ddkn/pwjsignal/pcb/pwjsignal/pwjsignal_rev_b.png

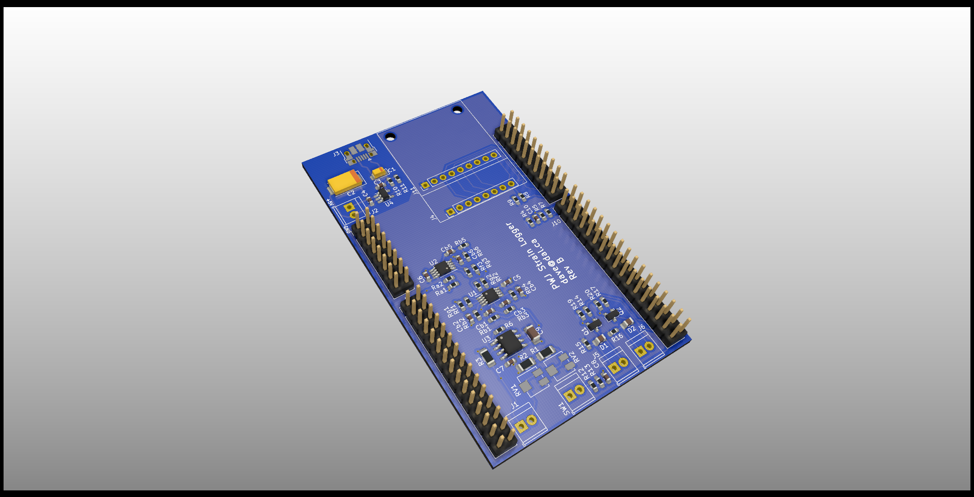
pcb/pwjsignal/pwjsignal_rev_b.png
