ddkn/pwjsignal/pcb/pwjsignal/pwjsignal.png

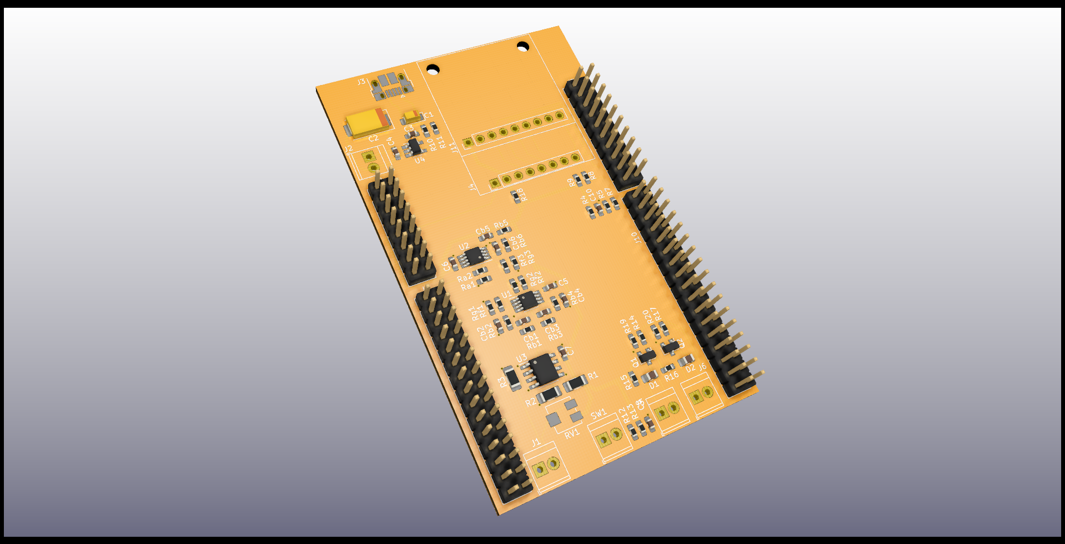
pcb/pwjsignal/pwjsignal.png
