ddkn/pwjsignal/README.md

# PWJSignal Daughter Board

This is the daughter board to the [pwjrtos](https://github.com/nanomagneticslab/pwjrtos)
OS. This was built using KiCAD v5.1.5.

These are design files for the PCB; this includes,

* Schematics
* PCB layouts
* Gerbers (for PCB manufacturers)
* Datasheet references
