ddkn/pwjsignal/pcb/pwjsignal/pwjsignal.kicad_pcb

## KiCad design pcb/pwjsignal/pwjsignal.kicad_pcb (2021-06-24)

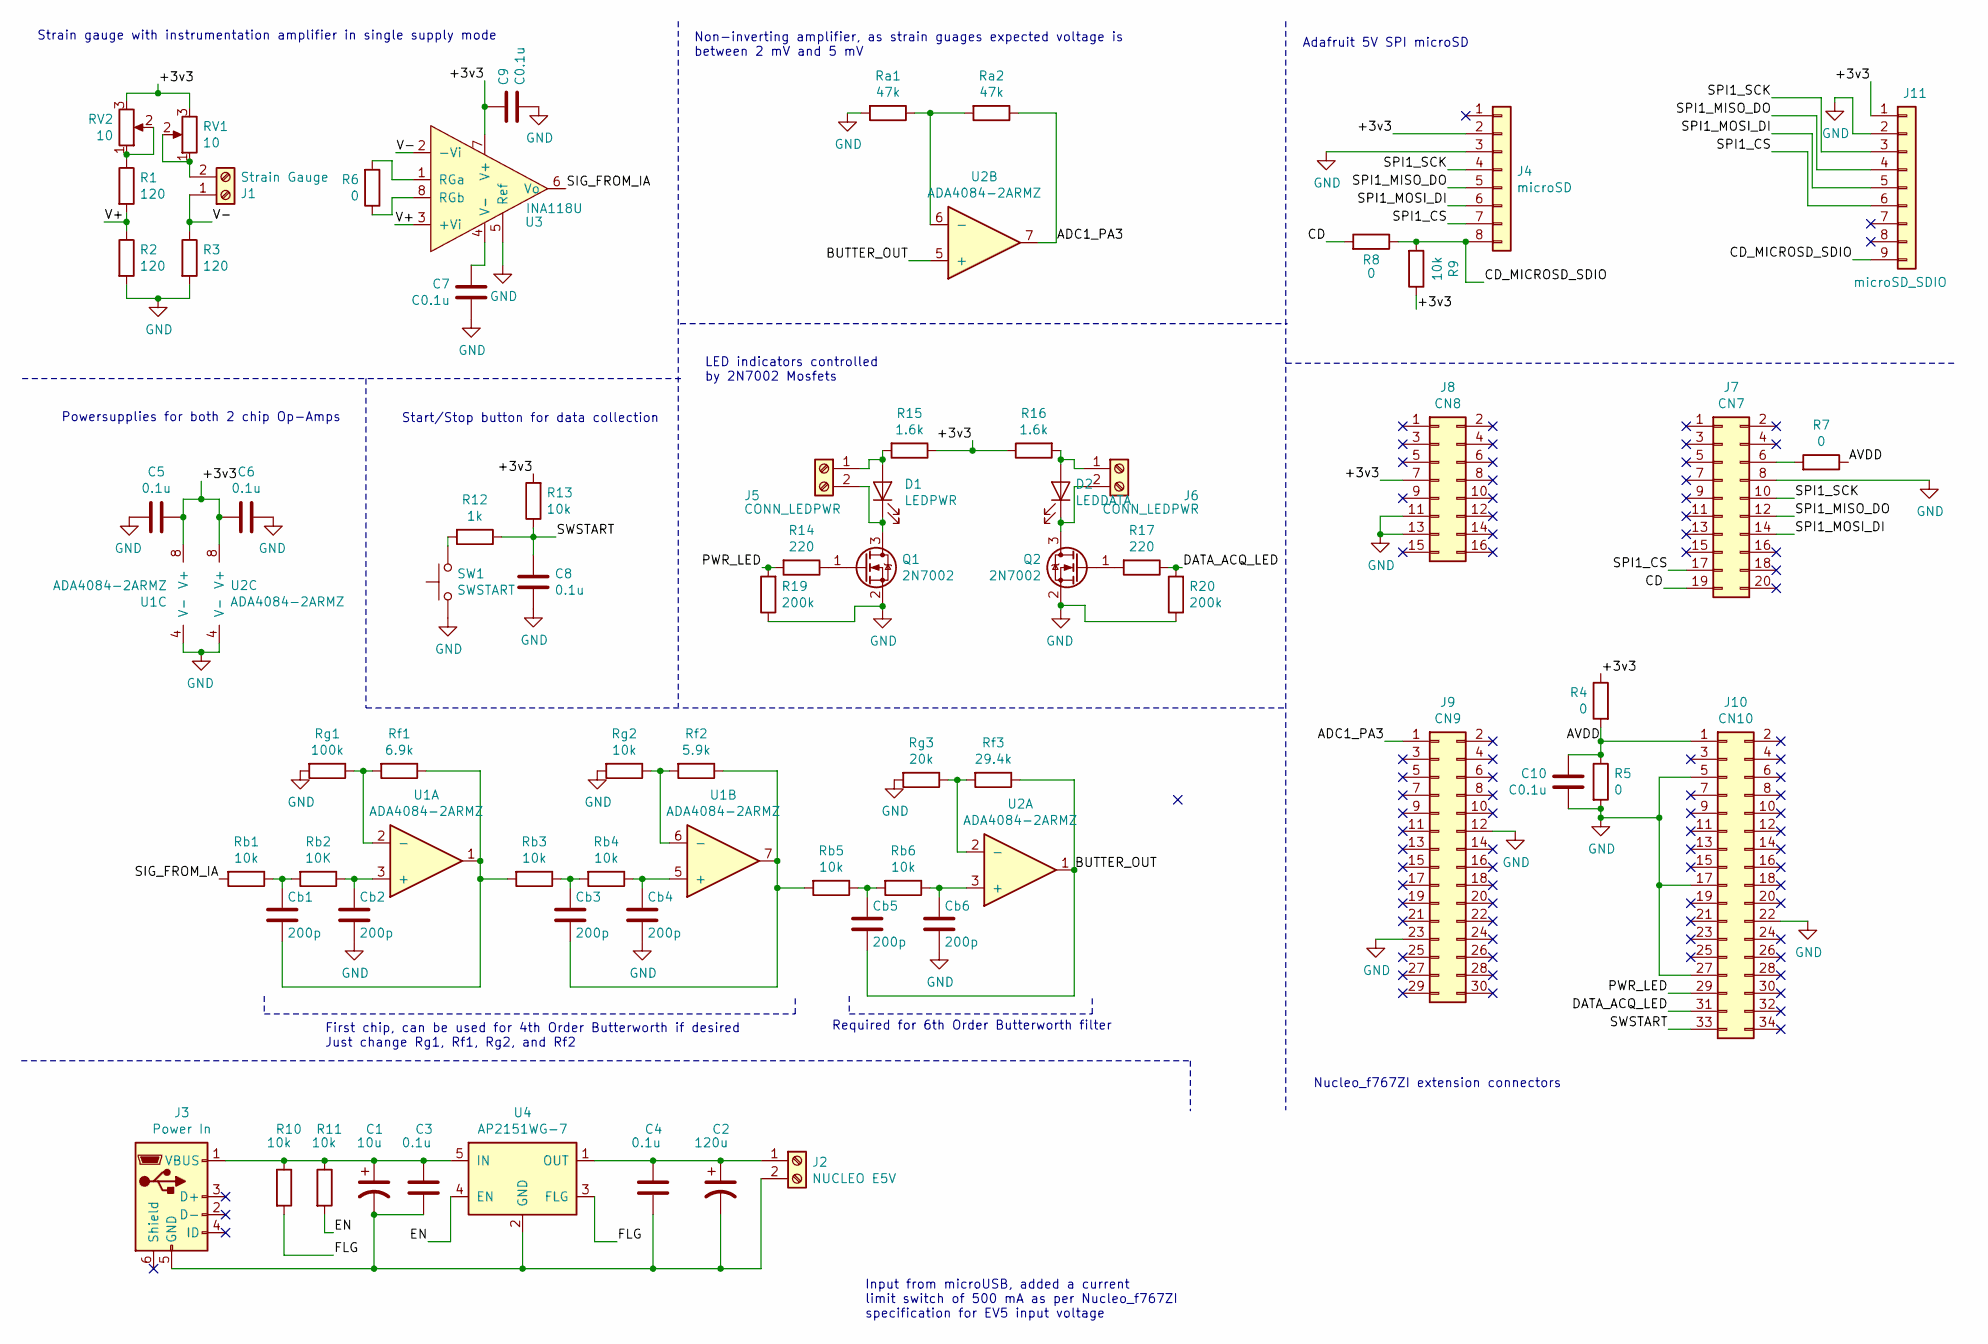
[picture p3: schematic pwjsignal.sch, PWJ Strain Logger]

Parts:
C1: 10u; CP_EIA-3216-18_Kemet-A_Pad1.58x1.35mm_HandSolder; MPN TAJA106K006SNJ
C2: 120u; CP_EIA-7343-15_Kemet-W_Pad2.25x2.55mm_HandSolder; MPN 293D127X96R3D2TE3
C3, C4, C5, C6, C8: 0.1u; C_0603_1608Metric_Pad1.05x0.95mm_HandSolder
C7, C10: C0.1u; C_0603_1608Metric_Pad1.05x0.95mm_HandSolder
C9: C0.1u; C_1206_3216Metric_Pad1.42x1.75mm_HandSolder
Cb1, Cb2, Cb3, Cb4, Cb5, Cb6: 200p; C_0603_1608Metric_Pad1.05x0.95mm_HandSolder
D1: LEDPWR; C_0805_2012Metric_Pad1.15x1.40mm_HandSolder; MPN APT2012LVBC/D
D2: LEDDATA; C_0805_2012Metric_Pad1.15x1.40mm_HandSolder; MPN APT2012LSECK/J4-PRV
J1: Strain Gauge; TerminalBlock_TE_282834-2_1x02_P2.54mm_Horizontal; MPN 1546215-2
J2: NUCLEO E5V; TerminalBlock_TE_282834-2_1x02_P2.54mm_Horizontal; MPN 1546215-2
J3: Power In; USB_Micro-B_Amphenol_10103594-0001LF_Horizontal; MPN 10103594-0001LF
J4: microSD; Adafruit_microSD_breakout_Alt; MPN 61300811121
J5, J6: CONN_LEDPWR; TerminalBlock_TE_282834-2_1x02_P2.54mm_Horizontal; MPN 1546215-2
J7: CN7; PinHeader_2x10_P2.54mm_Vertical; MPN 61307221121
J8: CN8; PinHeader_2x08_P2.54mm_Vertical; MPN 61307221121
J9: CN9; PinHeader_2x15_P2.54mm_Vertical; MPN 61307221121
J10: CN10; PinHeader_2x17_P2.54mm_Vertical; MPN 61307221121
J11: microSD_SDIO; Adafruit_microSD_SDIO_breakout
Q1, Q2: 2N7002; SOT-23; MPN 2N7002A-7
R1, R2, R3: 120; R_1206_3216Metric_Pad1.42x1.75mm_HandSolder
R4, R5, R6, R7, R8: 0; R_0603_1608Metric_Pad1.05x0.95mm_HandSolder
R9, R10, R11, R13: 10k; R_0603_1608Metric_Pad1.05x0.95mm_HandSolder
R12: 1k; R_0603_1608Metric_Pad1.05x0.95mm_HandSolder
R14, R17: 220; R_0603_1608Metric_Pad1.05x0.95mm_HandSolder
R15, R16: 1.6k; R_0603_1608Metric_Pad1.05x0.95mm_HandSolder
R19, R20: 200k; R_0603_1608Metric_Pad1.05x0.95mm_HandSolder
RV1, RV2: 10; Potentiometer_Bourns_3214J_Horizontal; MPN PVG3A200C01R00
Ra1, Ra2: 47k; R_0603_1608Metric_Pad1.05x0.95mm_HandSolder
Rb1, Rb3, Rb4, Rb5, Rb6: 10k; R_0603_1608Metric_Pad1.05x0.95mm_HandSolder
Rb2: 10K; R_0603_1608Metric_Pad1.05x0.95mm_HandSolder
Rf1: 6.9k; R_0603_1608Metric_Pad1.05x0.95mm_HandSolder
Rf2: 5.9k; R_0603_1608Metric_Pad1.05x0.95mm_HandSolder
Rf3: 29.4k; R_0603_1608Metric_Pad1.05x0.95mm_HandSolder
Rg1: 100k; R_0603_1608Metric_Pad1.05x0.95mm_HandSolder
Rg2: 10k; R_0603_1608Metric_Pad1.05x0.95mm_HandSolder
Rg3: 20k; R_0603_1608Metric_Pad1.05x0.95mm_HandSolder
SW1: SWSTART; TerminalBlock_TE_282834-2_1x02_P2.54mm_Horizontal
U1, U2: ADA4084-2ARMZ; MSOP-8_3x3mm_P0.65mm; MPN ADA4084-2ARMZ
U3: INA118U; SOIC-8_3.9x4.9mm_P1.27mm
U4: AP2151WG-7; SOT-23-5_HandSoldering; MPN AP2151WG-7

Connections:
/+3v3: C5.1, C6.2, C9.2, J4.2, J8.7, J11.1, R4.1, R9.1, R13.2, R15.1, R16.1, RV1.3, RV2.3, U1.8 (V+), U2.8 (V+), U3.7 (V+)
/ADC1_PA3: J9.1, Ra2.1, U2.7
/AVDD: C10.2, J10.1, R4.2, R5.1, R7.1
/BUTTER_OUT: Cb5.2, Rf3.1, U2.1, U2.5 (+)
/CD: J7.19, R8.2
/CD_MICROSD_SDIO: J4.8, J11.9, R8.1, R9.2
/DATA_ACQ_LED: J10.31, R17.1, R20.2
/EN: R11.2, U4.4 (EN)
/FLG: R10.2, U4.3 (FLG)
/PWR_LED: J10.29, R14.2, R19.2
/SIG_FROM_IA: Rb1.2, U3.6 (Vo)
/SPI1_CS: J4.7, J7.17, J11.6
/SPI1_MISO_DO: J4.5, J7.12, J11.4
/SPI1_MOSI_DI: J4.6, J7.14, J11.5
/SPI1_SCK: J4.4, J7.10, J11.3
/SWSTART: C8.1, J10.33, R12.1, R13.1
/V+: R1.2, R2.1, U3.3 (+Vi)
/V-: J1.1, R3.1, U3.2 (-Vi)
GND: C5.2, C6.1, C7.1, C8.2, C9.1, C10.1, Cb2.2, Cb4.2, Cb6.2, J4.3, J7.8, J8.11, J8.13, J9.12, J9.23, J10.5, J10.17, J10.22, J10.27, J11.2, Q1.2 (S), Q2.2 (S), R2.2, R3.2, R5.2, R19.1, R20.1, Ra1.2, Rg1.2, Rg2.2, Rg3.2, SW1.1, U1.4 (V-), U2.4 (V-), U3.5 (Ref)
unnamed: C1.1, C3.1, J3.1 (VBUS), R10.1, R11.1, U4.5 (IN)
unnamed: C1.2, C2.2, C3.2, C4.2, J2.2, J3.5 (GND), U4.2 (GND)
unnamed: C2.1, C4.1, J2.1, U4.1 (OUT)
unnamed: C7.2, U3.4 (V-)
unnamed: Cb1.1, Rb1.1, Rb2.2
unnamed: Cb1.2, Rb3.2, Rf1.1, U1.1
unnamed: Cb2.1, Rb2.1, U1.3 (+)
unnamed: Cb3.1, Rb3.1, Rb4.2
unnamed: Cb3.2, Rb5.2, Rf2.1, U1.7
unnamed: Cb4.1, Rb4.1, U1.5 (+)
unnamed: Cb5.1, Rb5.1, Rb6.2
unnamed: Cb6.1, Rb6.1, U2.3 (+)
unnamed: D1.1 (K), J5.2, Q1.3 (D)
unnamed: D1.2 (A), J5.1, R15.2
unnamed: D2.1 (K), J6.2, Q2.3 (D)
unnamed: D2.2 (A), J6.1, R16.2
unnamed: J1.2, RV1.1, RV1.2
unnamed: J7.6, R7.2
unnamed: Q1.1 (G), R14.1
unnamed: Q2.1 (G), R17.2
unnamed: R1.1, RV2.1, RV2.2
unnamed: R6.1, U3.8 (RGb)
unnamed: R6.2, U3.1 (RGa)
unnamed: R12.2, SW1.2
unnamed: Ra1.1, Ra2.2, U2.6 (-)
unnamed: Rf1.2, Rg1.1, U1.2 (-)
unnamed: Rf2.2, Rg2.1, U1.6 (-)
unnamed: Rf3.2, Rg3.1, U2.2 (-)

Notes on the sheet:
Input from microUSB, added a current limit switch of 500 mA as per Nucleo_f767ZI specification for EV5 input voltage
Adafruit 5V SPI microSD
Nucleo_f767ZI extension connectors
Strain gauge with instrumentation amplifier in single supply mode
Non-inverting amplifier, as strain guages expected voltage is between 2 mV and 5 mV
First chip, can be used for 4th Order Butterworth if desired Just change Rg1, Rf1, Rg2, and Rf2
Required for 6th Order Butterworth filter
Powersupplies for both 2 chip Op-Amps
Start/Stop button for data collection
LED indicators controlled by 2N7002 Mosfets

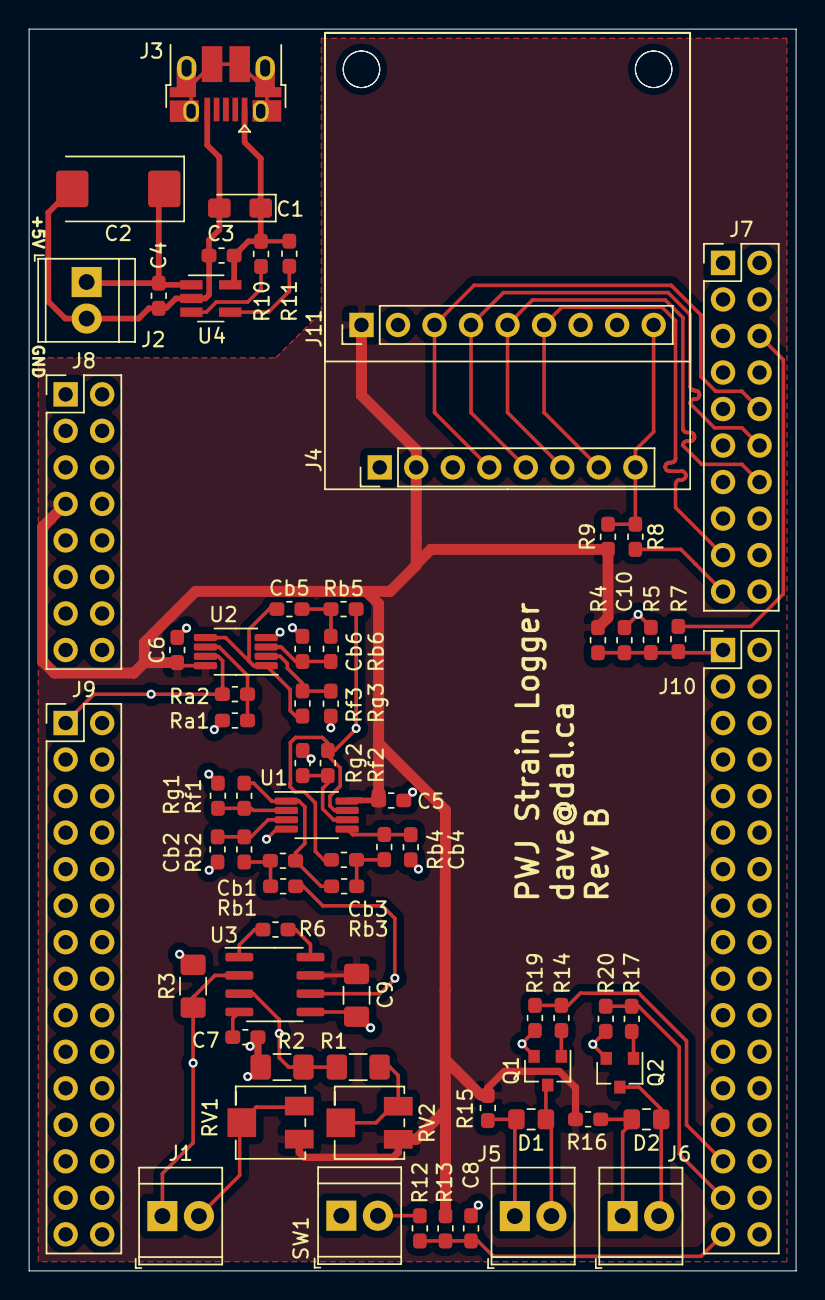
[picture p4: board pwjsignal.kicad_pcb from above]

Board: 2 copper layers, 53.3 x 86.4 mm, 71 parts (0 on the bottom side), 47 nets.
