ddkn/pwjsignal/(commit log)

2021-05-15 Initial commit of Rev. A of pwjsignal daughter board
    [Bom_pwjstrainlogger_digikey.csv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]
2021-06-24 Added Rev B of board with updated filters
    * This includes new Low Pass filter cutoff frequency 80kHz.
    * New instrumentation amplifier for low noise
    * Added test points
    [pwjsignal-B_Cu.gbl, pwjsignal-B_Mask.gbs, pwjsignal-B_SilkS.gbo, pwjsignal-Edge_Cuts.gm1, pwjsignal-F_Cu.gtl, pwjsignal-F_Mask.gts, pwjsignal-F_SilkS.gto, pwjsignal.drl]
